leaderstech-kiga/LTD_3x00B/README.md

# LTD\_3x00B

어보브 단독형 감지기

\## 프로젝트 정보

* 단독형 화재 감지기를 만드는 프로젝트임
* 회로설계로와 펌웨어 코드를 모두 개발해야되
* 펌웨어 개발환경은 Keil컴파일러를 사용해

\## 지침

* 펌웨어 코드는 \[LTD\_3x00B]폴더에 있어
* 회로도는\[LTD\_3x00B/회로도]폴더에 있어
* giuhub화일은 검토하지 말아줘

\## 규칙

* 회로도 분석은 저항 값이나 부품 값만 변경하는 검토만 해줘
* 펌웨어는 기능에 따른 주석을 자세히 달아줘
* 펌웨어 수정이 되면 원소스를 주석 으로 남겨줘
