leaderstech-kiga/LTD_3x00B/docs/session_2026-06-04.md

# LTD-3x00B 작업 세션 정리 (2026-06-04)

> 다음 세션 이어가기용 메모. `session_2026-05-30.md`(부팅/메인루프 브링업) 이후의 작업.
> 대상: A96L416 펌웨어 (Keil C51). 이번 세션은 **코드 재검토 + EMR_IO 핀 확정 + 알람/저전압 동작 개선**.
> ⚠️ 이 환경엔 C51 컴파일러가 없어 **빌드 미검증**. Keil에서 Rebuild 확인 필요.

## 1. 이번 세션에서 한 일 (요약)

1. **05-30 변경 4건 코드 재검토** (DataFlash fix / 부팅 시퀀스 / 메인루프 STEP1~5 / 저전압). DataFlash 경로는 견고함 확인(PageEr/PageWt가 Entry/Exit 자체 호출, 주소 0x3000 유효범위, buf[32]는 LARGE 모델이라 XDATA 배치 → 8051 스택 문제 없음, magic/checksum/gain==0 가드, DFMBUSY bounded 대기).
2. **EMR_IO 핀 매핑 확정 + 라벨 정정** — 회로도로 검증.
3. **EMR_IO 해제 시 Low 드라이브 충돌 제거** (2곳).
4. **`system_count` 랩어라운드 수정** (uint16→uint32).
5. **STEP5 SW2 long-press 엣지 검출** (누름 1회당 1회).
6. **저전압 음성 재생 중 LED_G 0.2초 점멸** (Timer2).
7. **화재 알람 SW2 정지(acknowledge) 기능** + 버스트 도중(클립 사이) 감지.

## 2. EMR_IO 핀 확정 (회로도 Sheet 4, EMERGNCY_I/O)

- **EMR_IO = MCU P10 (Port1.0, 패키지 4번 핀)** 로 확정. 펌웨어가 P1.0을 EMR_IO로 쓰는 것과 일치.
- EMR_IO 네트: **R26 = 220K 풀다운(GND)** + C11 270pF + V1(NC) → R20(STGB1608-102MT 페라이트비드) → CON3(OUT). (이전 검토문서 `schematic_review_v1.md`의 "220k 풀업"은 오기 — 실제 GND 접지 = 풀다운으로 확인.)
- 결론: **active-high 펌웨어 + 220K 풀다운**은 서로 일치(평상시 Low=알람 없음). 폴라리티 문제 없음.

라벨 정정:
- `a96l41x_gpio.c` P0.1 — 잘못된 `// EMR_IO` 라벨 삭제 (P0.1은 실제 OP1N / AN1 배터리 ADC).
- `a96l41x_gpio.c` / `main.c`(hw_initial 중복 블록) P1.0 — `// SENSE PW` → `// EMR_IO`.

## 3. 펌웨어 변경 상세 (모두 main.c, 일부 gpio.c)

### 3-1. EMR_IO 해제 Low 드라이브 제거
- `fire_monitor_step` 화재 해제부 + STEP5 수동테스트 해제부 두 곳에서 `P10 = 0;` 적극 Low 구동 제거(주석 처리). 곧바로 `Port_SetInputpin(PORT1,PIN0,0)`로 입력(High-Z) 전환 → 외부 220K 풀다운이 Low 처리. 다중 유닛이 라인 공유 시 한 유닛이 High 구동 중인 순간의 짧은 Low 드라이브 충돌 방지.

### 3-2. system_count 랩어라운드 (main.c:98)
- `uint16_t` → `uint32_t`. 65536이 42/292/1458의 배수가 아니라 ~3.5시간마다 modulo 위상이 어긋나던 문제 해소(32비트는 ~26년). 선언·대입·모듈로·증가에만 사용 → 동작 변화 없음.

### 3-3. STEP5 SW2 엣지 검출
- 전역 `sw2_prev_pressed` / `sw2_cur_pressed` 추가. STEP5에서 `cur && !prev`일 때만 진입(해제→눌림 엣지). 루프 끝에서 `prev=cur` 갱신. 누른 채로 있어도 테스트/보정이 매 wake 반복되지 않음(long-press=1회).

### 3-4. 저전압 LED_G 0.2초 점멸
- `TIMER2_Int` ISR의 기존 `Bat_Alarm_LED` 블록은 비정적 지역변수(`Gled_mode`/`GLED_CNT`)에 의존해 상태 미유지 = 사실상 미동작 코드였음 → 화재 LED와 동일하게 전역 `Timer2_cnt` 토글 방식으로 교체(`(Timer2_cnt & 0x01)`), 죽은 지역변수 제거.
- 헬퍼 추가: `lowbat_led_blink_start()`(T2_init + Bat_Alarm_LED=1 + Timer2_Start) / `lowbat_led_blink_stop()`(Timer2_Stop + Bat_Alarm_LED=0 + LED_G_OFF).
- 호출부 2곳 래핑: `battery_check()`의 High→Low 진입 즉시 1회 + STEP3 주기 반복. 둘 다 start … `Play_Clip(AUDIO_CLIP_LOWBAT)` … stop.
- 원리: Play_Clip은 블로킹이나 오디오가 Timer1 ISR로 백그라운드 재생 → 전역 인터럽트 ON → Timer2 ISR이 계속 떠 LED_G 깜박. 화재(LED_R)·저전압(LED_G)은 시간상 비중첩.

### 3-5. 화재 알람 SW2 정지(acknowledge) + 버스트 도중 감지
- `play_fire_burst()` 반환형 `void`→`uint8_t`. 화재음 `FIRE_VOICE_REPEAT`(=3, `AUDIO_CLIP_COUNT`와 동일)회 재생 중, **각 클립 사이 0.3초 갭에서 SW2를 20ms 간격 폴링**. 눌리면 `aborted=1`로 남은 클립 멈추고 반환. (외부 연동 relay `with_led=0`은 기존 그대로, 폴링/중단 없음, 0 반환.)
- `fire_monitor_step()` 화재 확정 루프: 매 사이클 P10 High 구동 → `ack = play_fire_burst(1)` → P10 입력 전환 → **`ack`(버스트 중 눌림) 또는 버스트 후 SW2 눌림**이면 `Play_Clip(AUDIO_CLIP_BOOT)` 후 `break`(메인루프 복귀). 아니면 `fire_confirm_avg`로 재감시, 연기 지속 시 루프 반복.

## 4. 알려진 제약 / 주의

1. **버튼 감지 시점**: `Play_Clip`은 블로킹이라 한 클립(~3초) 재생 중에는 SW2를 못 읽고, **클립 사이 0.3초 갭에서만** 감지. 짧게 톡 누르면 놓칠 수 있음 → 클립 끝까지 살짝 누르고 있어야 확실. 클립 재생 중 즉시 중단까지 원하면 오디오 엔진(Play_Clip/Timer1 ISR) 수정 필요(범위 큼, 미적용).
2. **acknowledge 후 재알람**: BOOT음 후 메인루프로 복귀해도 연기가 남아 있으면 다음 STEP1 주기(~8초)에서 다시 화재 감지 → 재알람(영구 묵음 아님). hush 타이머 원하면 별도 작업.
3. **빌드 미검증** — Keil Rebuild 필수.
4. 주석/문서는 한글, **소스(.c)는 ASCII 영문 주석 + CRLF 유지**(원래 ASCII 파일이라 UTF-8 한글 넣으면 Keil(CP949)에서 깨짐).
5. 원소스 보존: 라인 단위 변경은 주석 처리로 남김(`//P10 = 0; ...`). 구조 변경(화재 루프 재작성)은 nested-comment 제약상 인라인 대신 **git 이력에 보존**(되돌리기 가능).

## 5. 변경 파일

```
src/main.c            ← EMR_IO 해제(2곳), system_count uint32, STEP5 엣지,
                         저전압 LED_G(ISR+헬퍼+호출부), 화재 SW2 정지/버스트 감지,
                         P1.0 라벨(hw_initial)
src/a96l41x_gpio.c    ← P0.1 EMR_IO 라벨 삭제, P1.0 SENSE PW→EMR_IO
docs/session_2026-06-04.md  ← 본 문서
```

git diff 요약: `a96l41x_gpio.c 4±`, `main.c 82+/55-`. 브레이스 균형 OK.

## 6. 다음 세션 작업 후보

- [ ] **Keil Rebuild + 빌드 검증** (최우선).
- [ ] 보드 실측: 화재 알람 중 SW2 정지(클립 사이 감지)·BOOT음·메인루프 복귀, 저전압 LED_G 0.2초 점멸, EMR_IO 연동(P10) High/풀다운 동작.
- [ ] (선택) 화재 클립 재생 도중 즉시 중단(오디오 엔진 인터럽트화).
- [ ] (선택) acknowledge 후 hush 타이머(일정 시간 재알람 억제).
- [ ] (보류) dead code 정리 — `TIMER2_Int`의 `Al_Stop_mode`/`In_Fire_al_mode` 참조(진입경로 없음, 무해). 사용자 요청으로 이번엔 놔둠.
- [ ] 잔여 임시파일 `docs/main_loop_design.md.tmp.*` 삭제(권한상 bash 삭제 불가, Windows에서).

## 7. 핵심 코드 위치 인덱스 (2026-06-04 기준, 빌드 전 라인은 변동 가능)

| 항목 | 파일 | 대략 위치 |
|---|---|---|
| `play_fire_burst` (SW2 갭 폴링, abort 반환) | src/main.c | ~354 |
| `fire_monitor_step` (화재 확정 루프, ack/BOOT/break) | src/main.c | ~400 |
| `battery_check` (저전압 LED_G 래핑) | src/main.c | ~383 |
| STEP3 저전압 반복 재생 (LED_G 래핑) | src/main.c | ~548 |
| STEP5 (SW2 엣지) | src/main.c | ~560 |
| `system_count` 선언 (uint32) | src/main.c | 98 |
| SW2 엣지 전역 `sw2_prev/cur_pressed` | src/main.c | ~101 |
| `TIMER2_Int` (LED_R 화재 / LED_G 저전압 토글) | src/main.c | ~1016 |
| GPIO 초기화 핀 라벨 (P0.1/P1.0=EMR_IO) | src/a96l41x_gpio.c | 80, 104 |
| 캘리브레이션 / DataFlash | src/calib.c, src/a96l41x_dataflash.c | (05-30 그대로) |
