leaderstech-kiga/LTD_3x00B/docs/session_2026-05-29.md

# LTD-3x00B 작업 세션 정리 (2026-05-29)

> 다음 세션 이어가기용 메모. 이전 v3 보고서(`firmware_review_v3.md`) 이후의 변경 사항을 기록합니다.

## 1. 이번 세션에서 한 일

### 1.1 시료 편차 대응 — Per-unit Calibration 설계 및 구현

**문제:** 7개 시료의 12% 연기 측정값 편차가 100~250 (2.5배), clean air 측정값 편차 6~75 (12배) → 단일 고정 threshold로 모든 시료 커버 불가.

**해결:** 시료별 baseline(offset) + gain_Q8 두 값을 내부 DataFlash(0x3000)에 저장.

```
Si_Da_norm = ((Si_Da_raw - baseline) × gain_Q8) >> 8
gain_Q8    = (200 × 256) / (Si_Da @ 12% smoke - baseline)
```

**검증 결과:** 7개 시료 모두 12% 연기에서 보정 후 199로 수렴.

### 1.2 3-Step 초기화 절차 (기존 제품 패밀리와 통일)

| Step | 트리거 | 동작 | LED |
|---|---|---|-----|
| 1. Flash erase | SW2 누른 채 부팅 | DataFlash 0x3000 page erase | LED_G↔LED_R 교차 3회 (250ms씩) |
| 2. Baseline 캡처 | DataFlash 비어있음 + SW2 1회 누름 | 현재 ADC값 baseline으로 저장 (gain=256) | LED_G 0.5초 깜박 → 누름 → 1초 점등 |
| 3. Smoke 보정 | Normal mode + SW2 < 500ms 짧게 누름 | 10초 대기 + 5초 측정 + gain 계산/저장 | LED_R 10s 점등 → 5s간 0.5초 깜박 |

상수:
- `CALIB_REF_DELTA = 200` (12% 연기에서 normalize 목표값)
- `CALIB_ALARM_THRESHOLD = 160` (= 200 × 80%, 알람 트리거)
- `CALIB_MIN_DELTA = 30` (Phase 3 거부 임계)
- `CALIB_SHORT_PRESS_MS = 500` (short press 상한)
- `CALIB_SMOKE_BLINK_MS = 500` (LED_R 깜박 주기)

### 1.3 UART 출력 게이트

`uart_debug_mode == uart_debug_On`일 때만 ADC 측정마다 `Uart_Out()` 호출. 양산 모드(`Debug_Off`, 기본값)에서는 `Get_Bat_Voltage_cV` + `Uart_Out` 둘 다 skip → 전력 절감.

main.c line 136에서 전환:
```c
uint8_t uart_debug_mode = Debug_Off ;   // 양산
uint8_t uart_debug_mode = Debug_On ;    // 시험
```

### 1.4 버그 fix
- `calib.c` line 55의 C247 컴파일 에러 (`code *` 포인터 non-constant initializer) → 베이스 포인터를 상수 `CALIB_ADDR`로 고정 + offset을 배열 인덱싱으로 처리.

## 2. 추가된/수정된 파일

### 신규 파일
```
src/a96l41x_dataflash.h    ← ABOV vendor sample 복사
src/a96l41x_dataflash.c    ← DataFlash 페이지 erase/write/byte write
src/calib.h                ← 캘리브레이션 모듈 헤더
src/calib.c                ← 캘리브레이션 모듈 구현
docs/calibration_design.md ← 설계 문서 v3
docs/session_2026-05-29.md ← 본 문서
```

### 수정 파일
- `src/main.c`:
  - `#include "calib.h"` 추가
  - boot 시퀀스에 Step 1 (`calib_erase_with_animation`) + Step 2 (`calib_boot_init`) 호출
  - main while loop 상단에 short-press 검출 + Step 3 (`calib_run_smoke_short`) 호출
  - ADC 블록에 dust 측정 + calib_apply + fire counter 추가
  - `ADC2_Dust_Val_Norm`, `fire_count` 전역 추가
  - UART 출력 라벨 `Norm:`/`Base:`/`Gain:`/`Cv:` 추가
  - UART 출력 호출을 `uart_debug_mode == uart_debug_On` 게이트로 감쌈

## 3. calib 모듈 공개 API

| 함수 | 역할 | 호출 위치 |
|---|---|---|
| `calib_load()` | DataFlash 읽기 + 검증 | calib_boot_init 내부 |
| `calib_save(b, g)` | 페이지 erase + write + 검증 | calib_boot_init, calib_run_smoke_short, calib_erase_with_animation 내부 |
| `calib_apply(raw)` | 정규화 (((raw-base)×gain)>>8) | main loop ADC 블록 |
| `calib_erase_with_animation()` | Step 1: LED 교차 + page erase | main() boot |
| `calib_boot_init()` | Step 2: load 또는 SW2 누름으로 baseline 캡처 + needs_smoke 플래그 세팅 | main() boot |
| `calib_run_smoke_short()` | Step 3: 10s 대기 + 5s 측정 + gain 계산/저장 | main loop short press 시 |

전역:
- `g_calib_baseline`, `g_calib_gain_Q8`, `g_calib_valid`, `g_calib_needs_smoke`

## 4. 빌드 상태

- ✅ Keil C51 컴파일 OK
- ⚠️ 라이팅 후 계속 리셋되는 증상 발생 → **a96l41x_dataflash.c가 Keil 프로젝트에 등록되지 않아 발생한 unresolved external** 추정
- 🟢 **다음 작업 시 첫 확인:** uVision에서 Project Window에 `a96l41x_dataflash.c`와 `calib.c` 둘 다 등록되어 있는지 확인 후 Rebuild All

## 5. 다음 세션 작업 후보

### 즉시 (다음 부팅 검증)
- [ ] **a96l41x_dataflash.c, calib.c 프로젝트 등록 + Rebuild** → 리셋 증상 해결 확인
- [ ] DataFlash erase 상태 부팅 → Step 2 LED_G 깜박 확인
- [ ] SW2 1회 누름 → LED_G 1초 점등 (baseline 저장)
- [ ] 재부팅 → UART `Cv:0001 Base:<측정값> Gain:0256 Norm:0000` 확인
- [ ] Normal 모드 → SW2 짧게 누름 → LED_R 점등 → 10s 대기 → LED_R 0.5초 깜박 5s → LED_G 3초 점등
- [ ] 12% 연기 챔버에서 위 절차 진행 후 → 재부팅 → 12% 연기 다시 → UART `Norm:~199` 확인
- [ ] 7개 시료 모두 보정 → 12% Norm 195~205 범위 검증

### 도구 환경
- [ ] **Keil + OCD2 통합 설정** (별도 라이팅 안 하고 Keil에서 바로 라이팅 + 디버그)
  - ABOV OCD 드라이버 (.DLL) 및 A96L41x.FLM 확보
  - Project Options → Debug 탭 → ABOV OCD 선택
  - Utilities 탭 → Flash 프로그래밍 알고리즘 추가
  - 자세한 절차: 이전 메시지 참조

### 후속 개선 (필요시)
- [ ] **저전압 알람** 재구현 — 현재 `if (Bat_mode == Bat_Low_mode) { }` 본체 비어있음. `Get_Bat_Voltage_cV()`를 `ck_led_time` 블록 안으로 옮기고 임계값 비교 추가
- [ ] **장기 drift 자동 보상** — 현재 step 1 (flash erase) 없이는 baseline 갱신 불가. 사용자가 주기적으로 재보정해야 함
- [ ] **Long press 동작 정의** — Normal 모드에서 SW2 ≥500ms hold 시 현재 동작 미정 (smoke cal 트리거 안 되고 그냥 무시). 화재 알람 테스트 등에 활용 가능
- [ ] **Fire alarm test trigger 버그 fix** — main.c line 356 부근의 `Port_GetInputpinValue(PORT1, PIN0)` 체크 — 주석에는 SW2라고 적혀있지만 실제로는 PIN0(P10) 검사. 의도가 PIN2였다면 수정 필요

## 6. 알려진 제약

1. **첫 baseline 캡처 = 사용자 책임** — Step 2에서 SW2 누르는 순간의 ADC가 baseline으로 잠김. 누르기 전 clean air 보장 필요.
2. **Smoke 재보정 = Step 1부터** — 한 번 성공 후 g_calib_needs_smoke=0 되어 short press 무력화. 재보정 시 flash erase 후 baseline 재캡처부터.
3. **Short press 최소 200ms** — WDT wake 간격(~0.192s) 때문에 너무 짧은 press(100ms 이하)는 놓칠 수 있음.
4. **Step 3 15초 블로킹** — Smoke cal 중 메인 루프 정지. 화재 감지 안 됨.

## 7. 핵심 코드 위치 인덱스

| 항목 | 파일 | 라인 |
|---|---|---|
| main() 진입점 | src/main.c | 273 |
| boot 시퀀스 (Step 1 + Step 2) | src/main.c | 309~316 |
| main loop short-press 검출 (Step 3 트리거) | src/main.c | 332~360 |
| main loop ADC 블록 (dust + calib_apply + fire counter + UART) | src/main.c | 369~427 |
| UART 출력 라벨 (Cal_*) | src/main.c | 192~199 |
| Uart_Out 함수 본체 | src/main.c | 1315~ |
| `ADC2_Dust_Val_Norm`, `fire_count` 전역 | src/main.c | 248~260 |
| `uart_debug_mode` 플래그 | src/main.c | 136 |
| `calib_erase_with_animation` | src/calib.c | 221 |
| `calib_boot_init` | src/calib.c | 309 |
| `calib_run_smoke_short` | src/calib.c | 344 |
| `calib_read_word` (C247 fix 적용) | src/calib.c | 53 |
| 캘리브레이션 상수 | src/calib.h | 56~89 |
| DataFlash 드라이버 본체 | src/a96l41x_dataflash.c | — |

## 8. 빠른 참조 — UART 출력 형식

uart_debug_mode = Debug_On 상태에서 ~8초마다 출력:

```
Visu_MODE: Bat:0299 Si_Off:0000 Si_On:0000 Si_Da:0000 Du_Off:00XX Du_On:00XX Si_Da:0190 Norm:0199 Base:0019 Gain:0299 Cv:0001
```

해석:
- `Bat:0299` = 2.99V
- 앞쪽 `Si_*` (3개) = 0000 (Dust_ADC_1AMP 미호출)
- 뒤쪽 `Du_*` + `Si_Da:` = Dust_ADC_2AMP 결과
- `Norm:` = calib_apply 결과 (160 초과 시 fire counter ↑)
- `Cv:0001` = DataFlash valid record load 성공
- `Cv:0000` = 캘리브레이션 기본값(baseline=0, gain=256) 사용 중

## 9. 참고 문서

- `docs/calibration_design.md` — 캘리브레이션 설계 v3 (현행)
- `docs/firmware_review_v3.md` — v3 전체 펌웨어 변경 이력
- `docs/firmware_review_v2.md` — v2 변경 이력
- `docs/firmware_review_v1.md` — 초기 코드 리뷰
