leaderstech-kiga/LTD_3x00B/회로도/LED.png

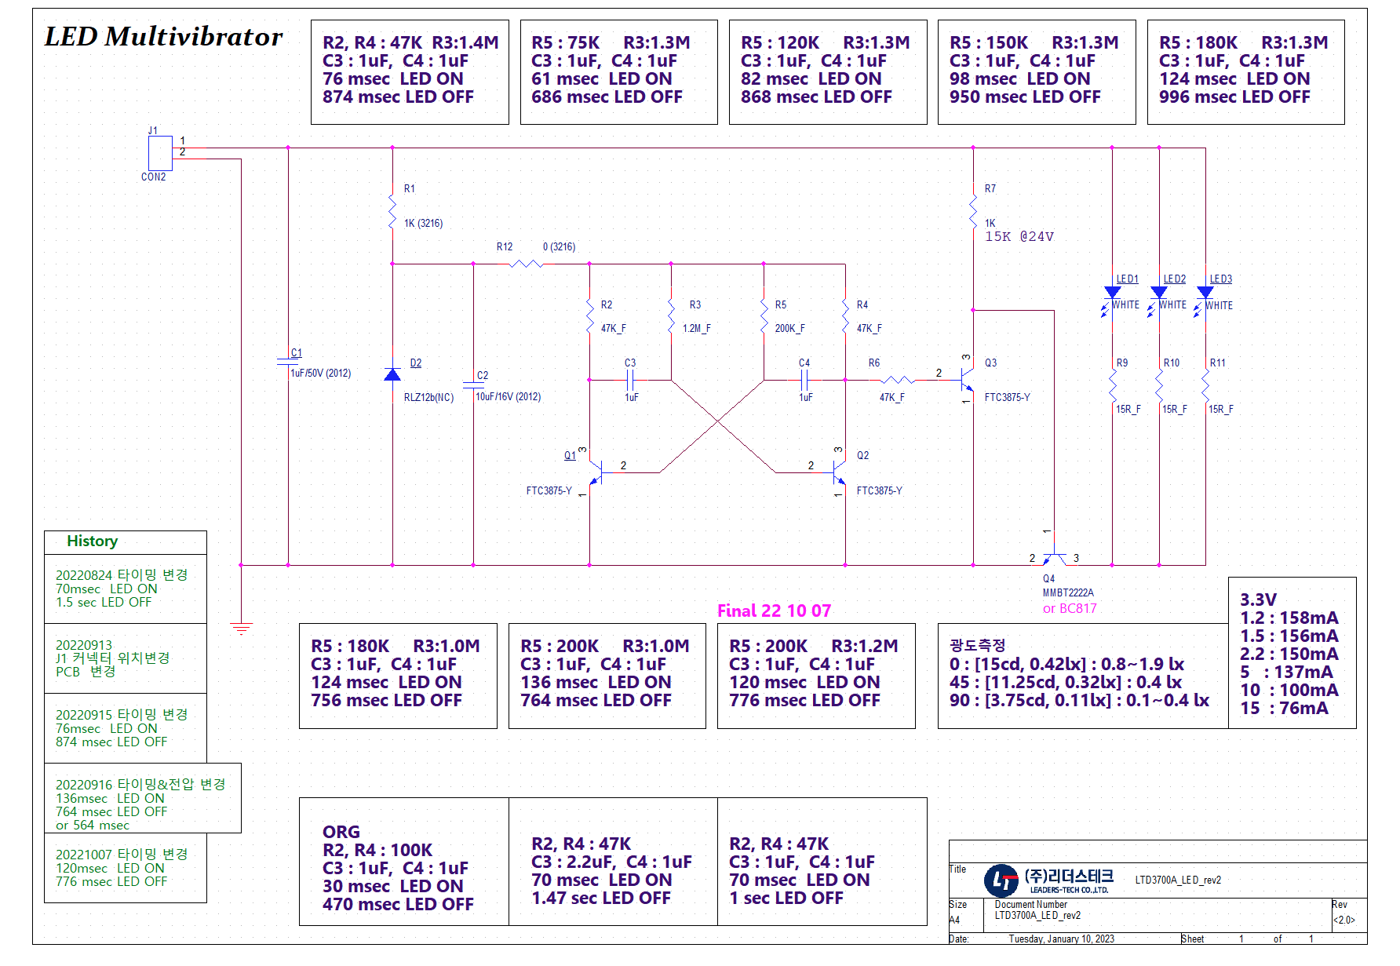
회로도/LED.png
