leaderstech-kiga/LTD_3x00B/회로도/거버화일.png

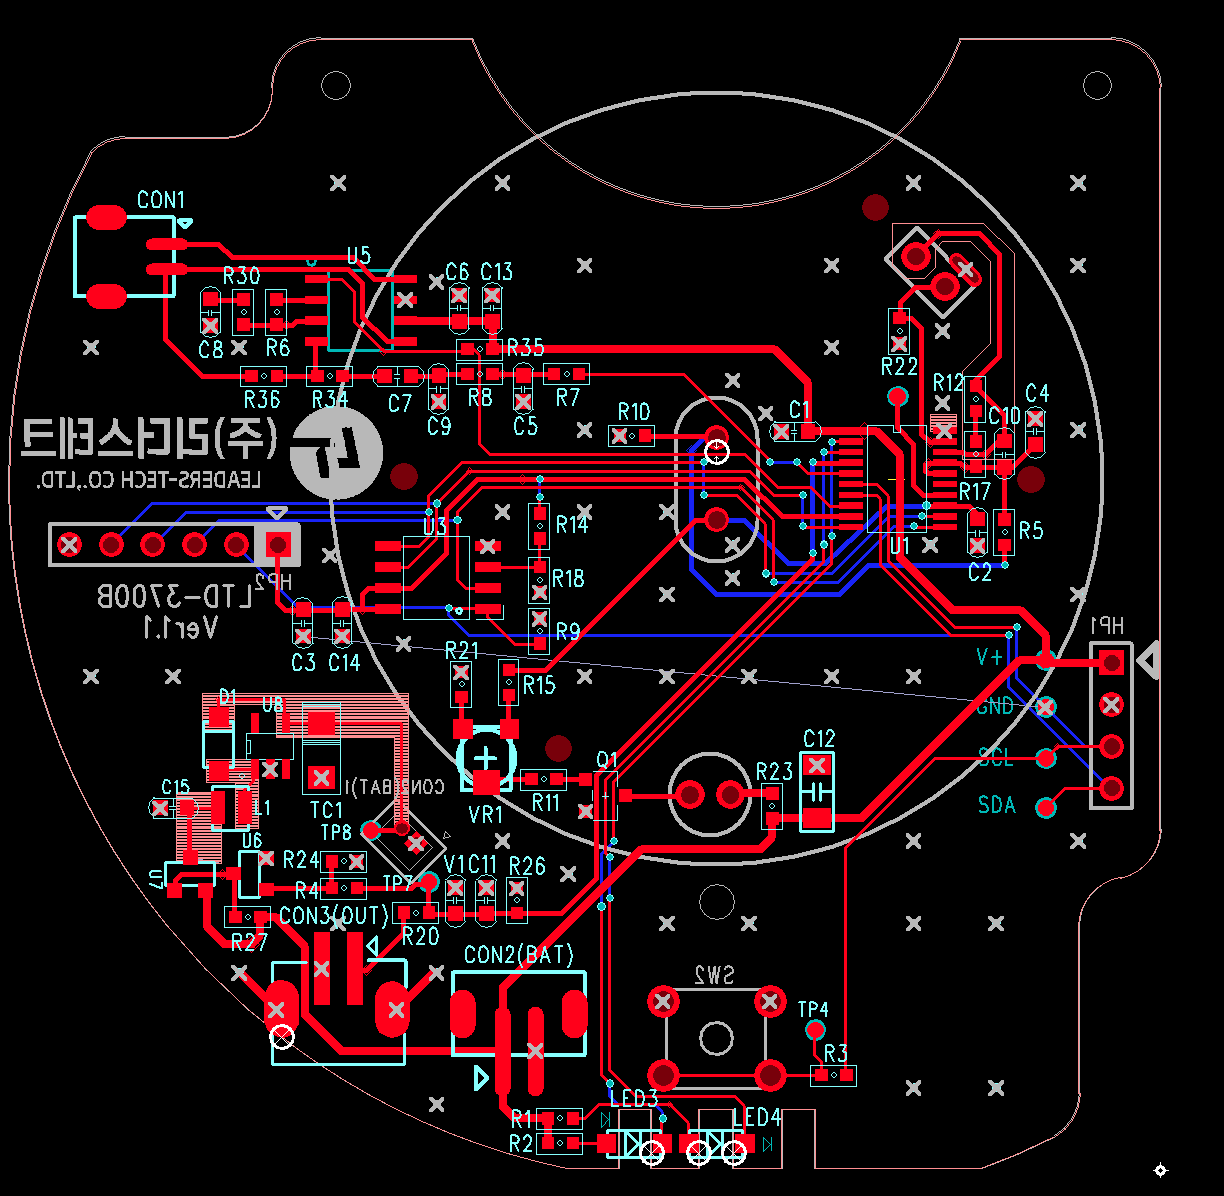
회로도/거버화일.png
