leaderstech-kiga/LTD_3x00B/회로도/LTD-3700B_V1.pdf

6 | 5 | 4 | 3 | 2 | 1

D

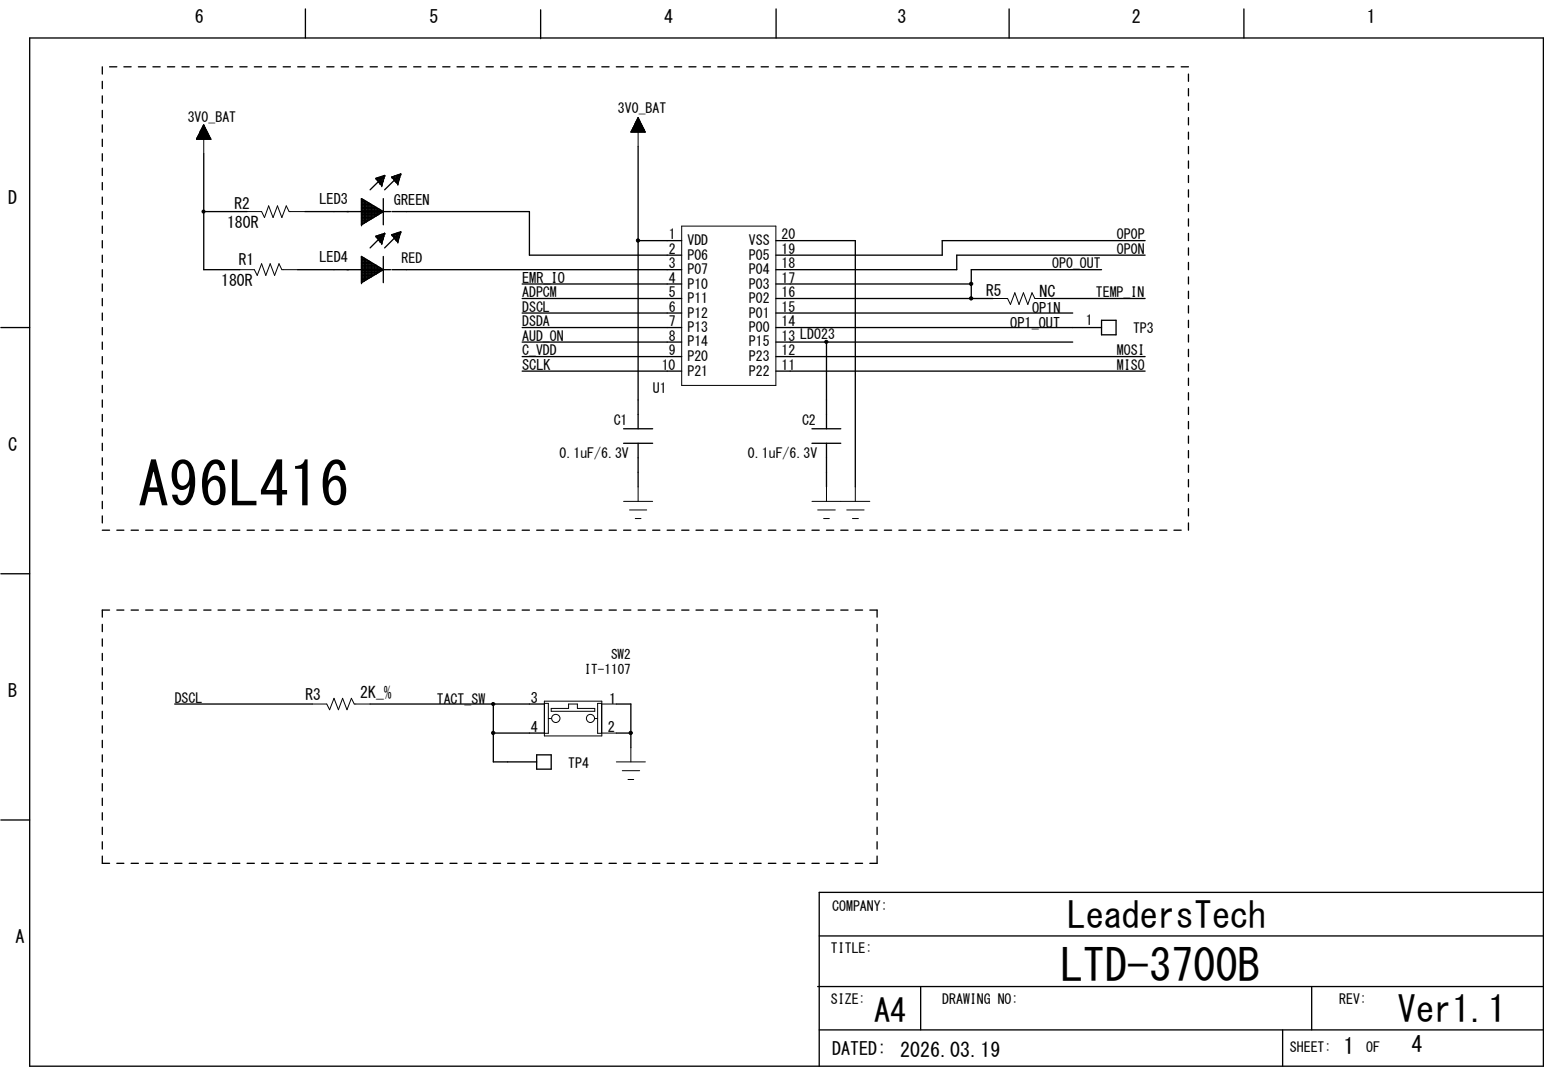
[picture p3: page 1]

SIZE: A4 | DRAWING NO: | REV: Ver1.1

DATED: 2026.03.19 | SHEET: OF 1 4

D

SPI_NOR_1Mb | AUDIO_AMP

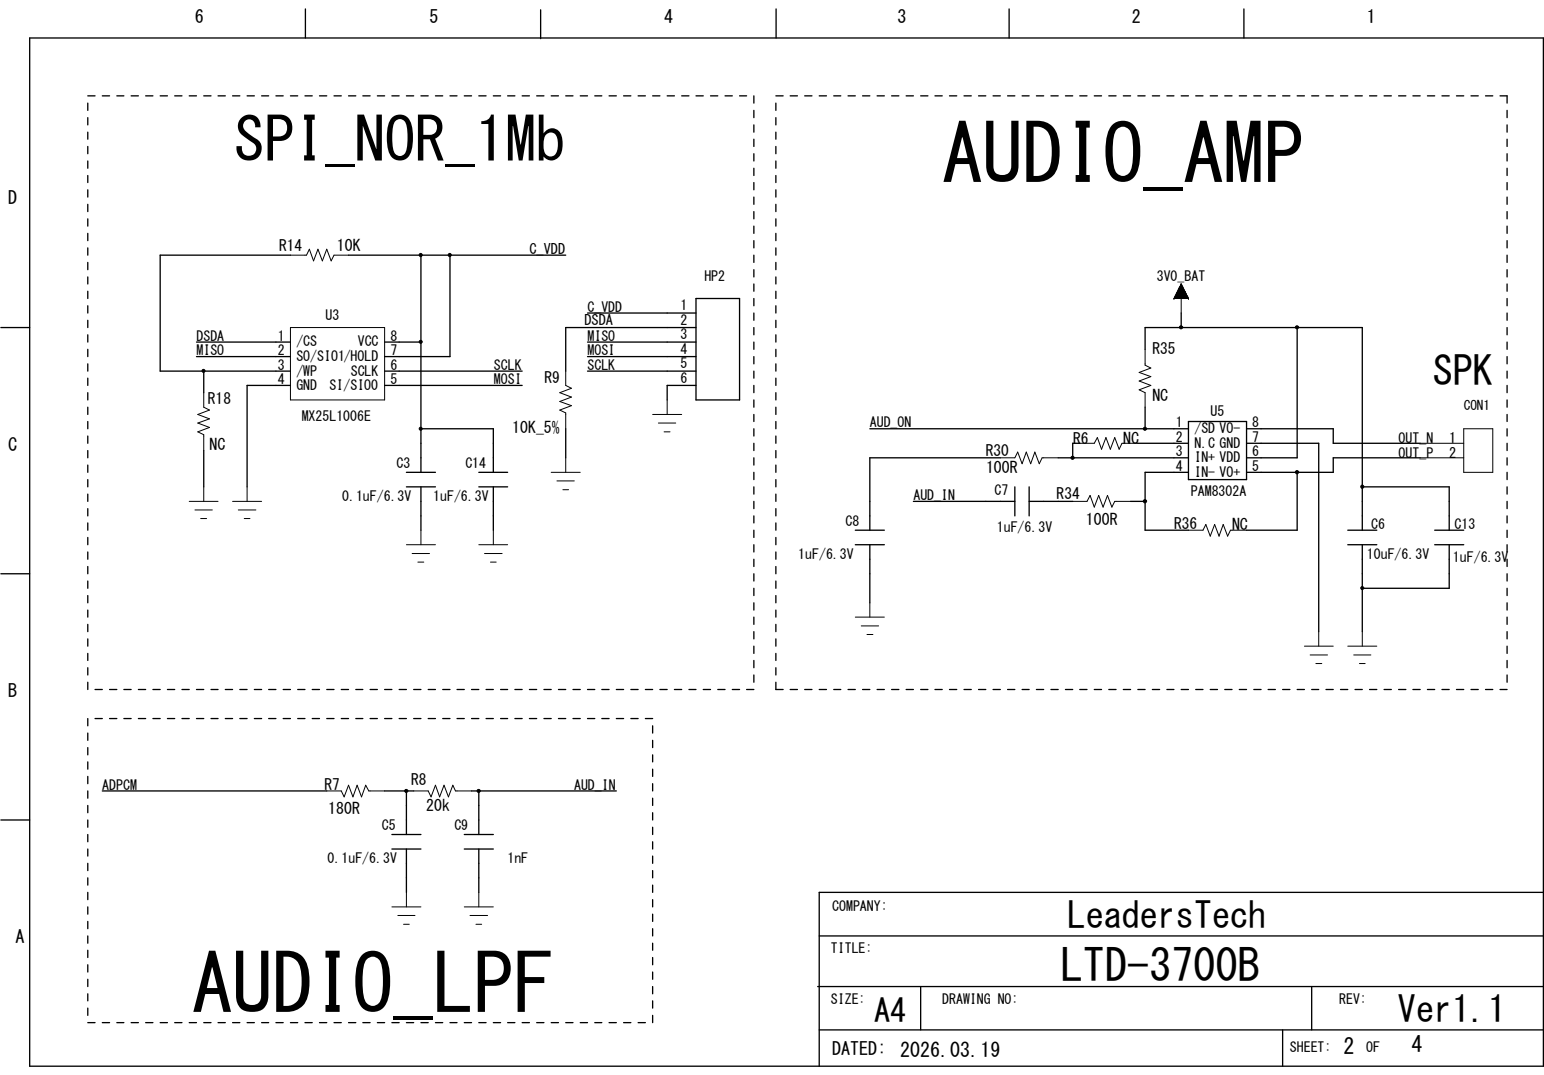
[picture p4: page 2]

D

열 연기검출회로 , | _광전식

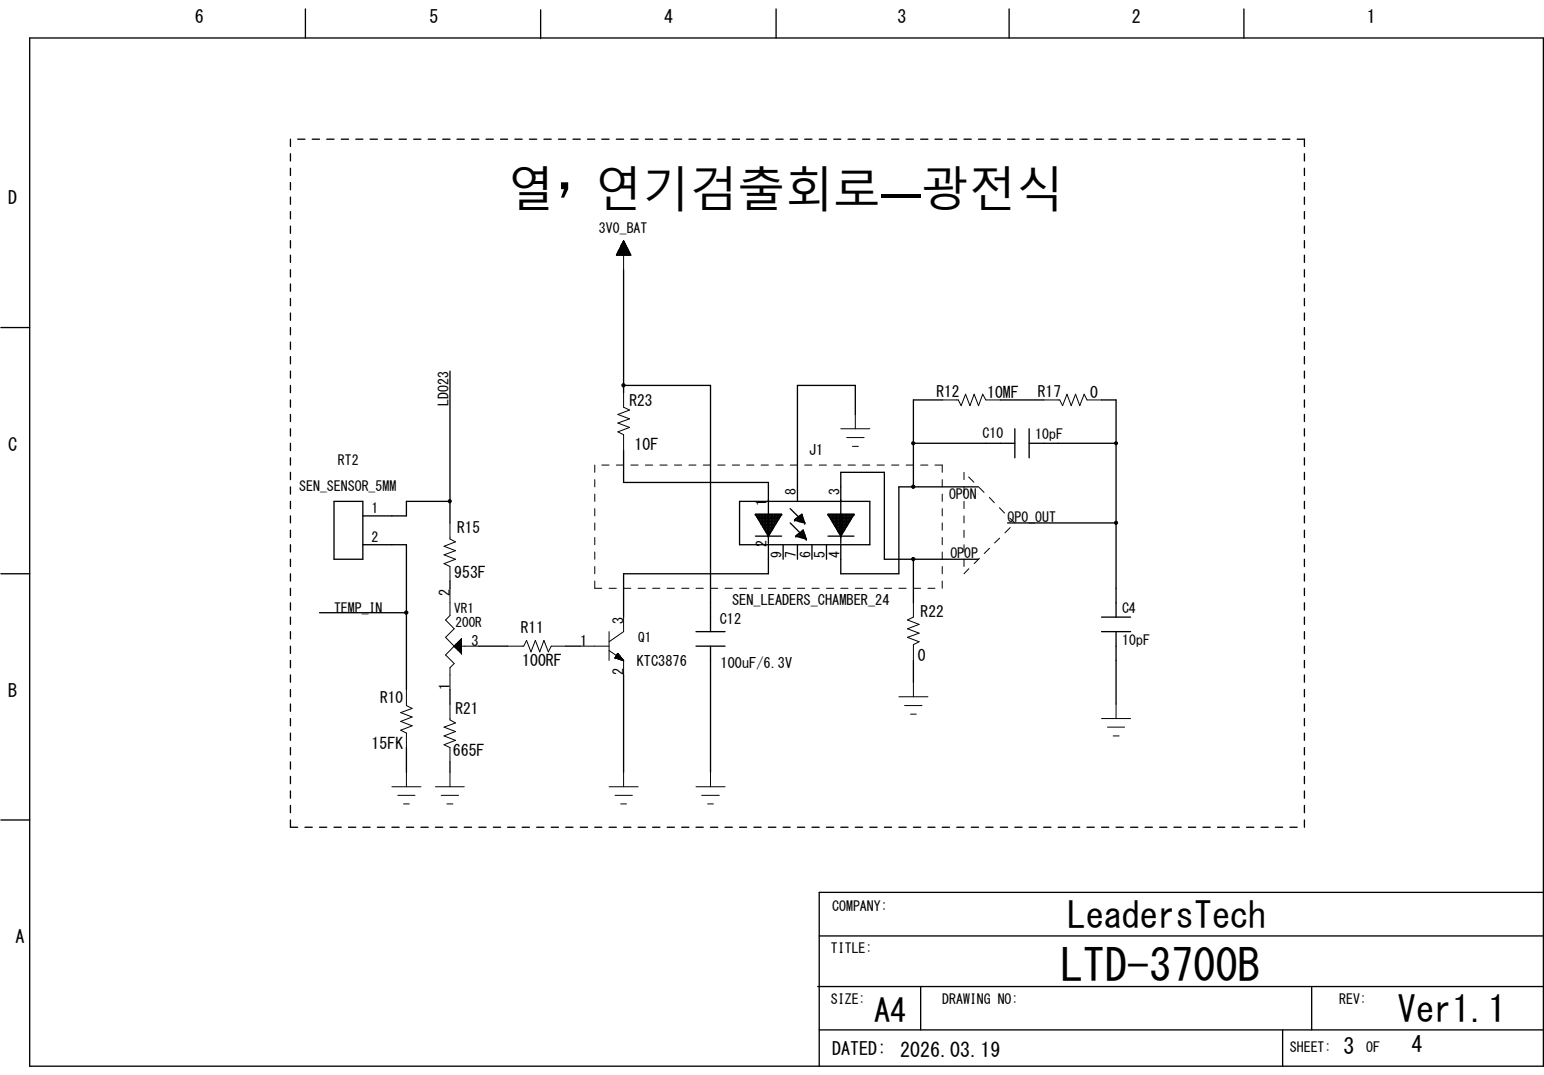
[picture p5: page 3]

D

# EMERGNCY_I/O

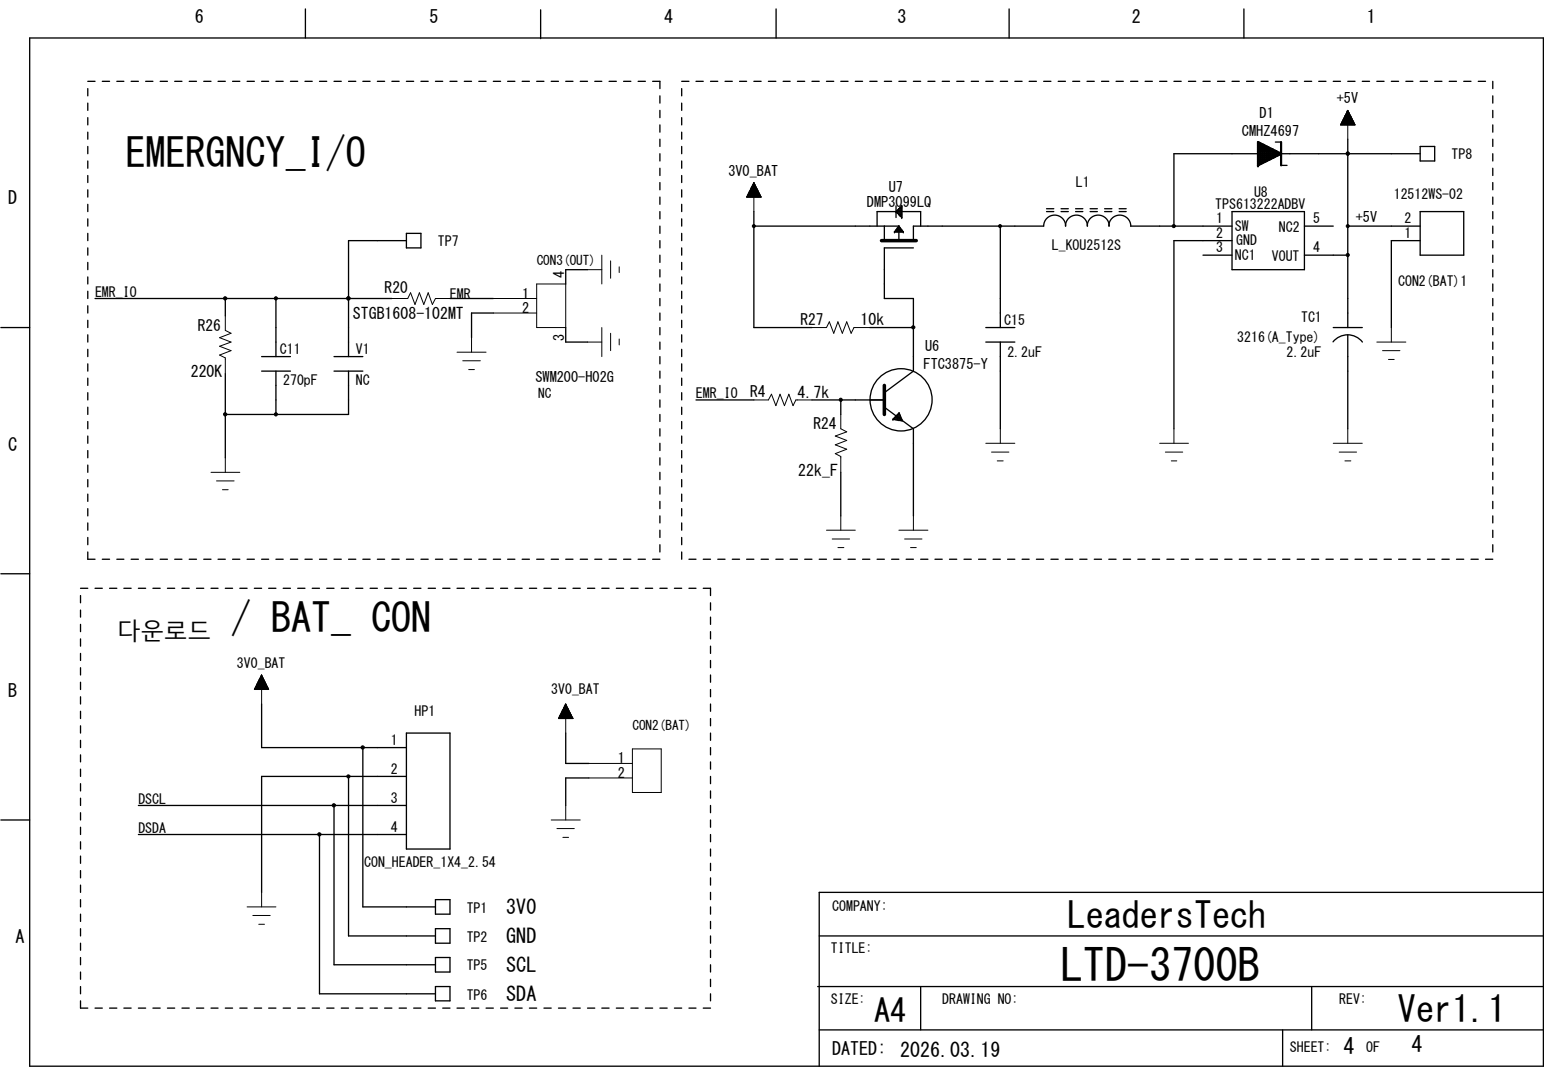
[picture p6: page 4]
