leaderstech-kiga/LTD_3x00B/자료/Stand_along_Abov/src/sound_fire1.h

//------------------------------------------------------------
//-----------       Created with 010 Editor        -----------
//------         www.sweetscape.com/010editor/          ------
//
// File    : Untitled1
// Address : 0 (0x0)
// Size    : 8990 (0x231E)
//------------------------------------------------------------
code unsigned char Table_fire[8990] = {			
    0x64, 0x61, 0x74, 0x61, 0x15, 0x23, 0x00, 0x00,
    0x80, 0x80, 0x80, 0x80, 0x80, 0x80, 0x80, 0x80,
    0x80, 0x80, 0x80, 0x80, 0x80, 0x80, 0x80, 0x80,
    0x80, 0x80, 0x80, 0x80, 0x80, 0x80, 0x80, 0x80,
    0x80, 0x80, 0x80, 0x80, 0x80, 0x80, 0x80, 0x80,
    0x80, 0x80, 0x80, 0x80, 0x80, 0x80, 0x80, 0x80,
    0x80, 0x80, 0x80, 0x80, 0x80, 0x80, 0x80, 0x80,
    0x80, 0x80, 0x80, 0x80, 0x80, 0x80, 0x80, 0x80,
    0x7F, 0x81, 0x80, 0x79, 0x7E, 0x81, 0x7F, 0x7E,
    0x7E, 0x81, 0x80, 0x7F, 0x7E, 0x7F, 0x81, 0x80,
    0x7B, 0x84, 0x78, 0x7C, 0x80, 0x81, 0x80, 0x80,
    0x81, 0x83, 0x80, 0x7F, 0x7E, 0x81, 0x77, 0x84,
    0x87, 0x74, 0x84, 0x80, 0x80, 0x7A, 0x76, 0x7B,
    0x8A, 0x89, 0x81, 0x7B, 0x89, 0x80, 0x72, 0x73,
    0x83, 0x75, 0x7F, 0x8A, 0x8F, 0x80, 0x77, 0x88,
    0x7D, 0x7B, 0x75, 0x80, 0x83, 0x81, 0x82, 0x7F,
    0x7D, 0x7D, 0x7A, 0x88, 0x83, 0x8C, 0x84, 0x7F,
    0x7F, 0x77, 0x77, 0x78, 0x81, 0x82, 0x87, 0x82,
    0x86, 0x86, 0x7D, 0x79, 0x73, 0x84, 0x81, 0x7F,
    0x82, 0x89, 0x8B, 0x72, 0x7B, 0x80, 0x7D, 0x7C,
    0x80, 0x84, 0x82, 0x80, 0x81, 0x84, 0x79, 0x7F,
    0x80, 0x7F, 0x75, 0x80, 0x8F, 0x80, 0x90, 0x7B,
    0x83, 0x77, 0x77, 0x75, 0x6E, 0x8C, 0x87, 0x8C,
    0x87, 0x7C, 0x88, 0x7E, 0x67, 0x77, 0x89, 0x83,
    0x88, 0x86, 0x7F, 0x85, 0x6F, 0x79, 0x6D, 0x86,
    0x8F, 0x88, 0x81, 0x7F, 0x81, 0x72, 0x75, 0x69,
    0x87, 0x98, 0x89, 0x81, 0x88, 0x7C, 0x79, 0x6B,
    0x79, 0x79, 0x80, 0x9F, 0x8E, 0x7A, 0x80, 0x78,
    0x83, 0x6A, 0x6B, 0x8A, 0x8F, 0x81, 0x7D, 0x90,
    0x78, 0x7C, 0x70, 0x7F, 0x7E, 0x80, 0x79, 0x82,
    0x9A, 0x7F, 0x72, 0x7B, 0x84, 0x7A, 0x6D, 0x83,
    0x83, 0x99, 0x86, 0x7E, 0x70, 0x81, 0x7A, 0x7A,
    0x79, 0x89, 0x70, 0x88, 0x81, 0x87, 0x89, 0x70,
    0x94, 0x7E, 0x88, 0x60, 0x86, 0x81, 0x7B, 0x70,
    0x91, 0x8C, 0x87, 0x76, 0x80, 0x86, 0x6D, 0x72,
    0x84, 0x97, 0x74, 0x86, 0x82, 0x85, 0x79, 0x7C,
    0x7A, 0x64, 0x79, 0x92, 0xA2, 0x74, 0x85, 0x8D,
    0x8C, 0x4D, 0x6C, 0x81, 0x82, 0x92, 0x90, 0x81,
    0x72, 0x8F, 0x79, 0x64, 0x65, 0xA9, 0x9E, 0x60,
    0x65, 0xA5, 0x97, 0x61, 0x77, 0x8F, 0x8A, 0x76,
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
};
	
