leaderstech-kiga/LTD_3x00B/(commit log)

2026-04-10 처음 커밋
2026-04-10 초기화 작업중
2026-04-16 기본 함수만 정리
2026-04-21 UART ADC 함수 구현
2026-04-24 베터리 값, 온도 센서 읽기, 정온식 광전식 자동 구분
    [MF52E-503H3950FAL36_RT_Table_v2.xlsx]
2026-05-27 1차 보정 작업
2026-06-01 클로드 1 작업 완료
2026-06-01 모든기능 구현 1차
2026-06-04 1차 완료
